chenfangshuo/G474PulseGen/screenshots/verification_2026-09/after_code-hygiene/1-1_sync_jitter.png

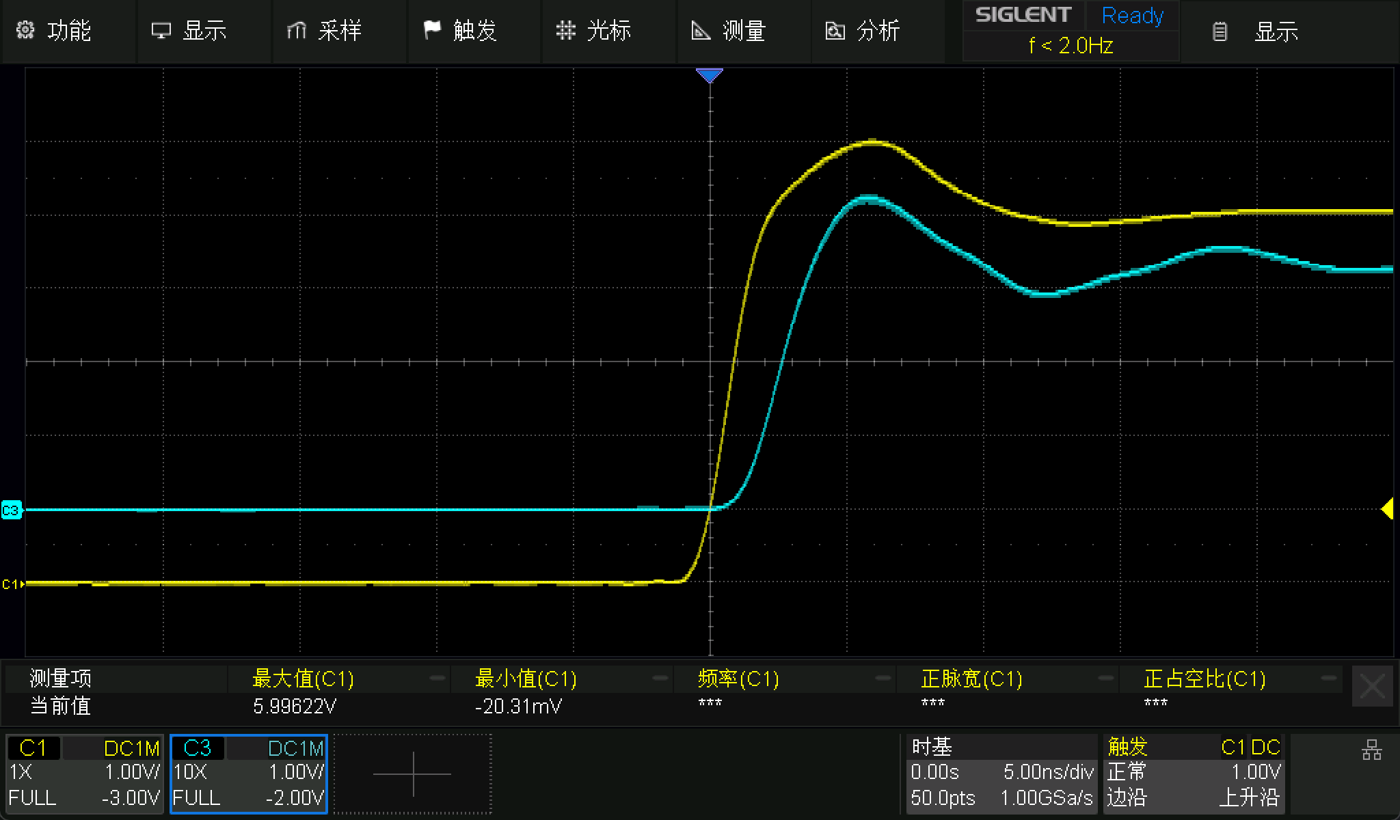
screenshots/verification_2026-09/after_code-hygiene/1-1_sync_jitter.png
