chenfangshuo/G474PulseGen/screenshots/verification_2026-09/after_code-hygiene/1-3_oled_pages/20260911_180122_COMPPWM_013.png

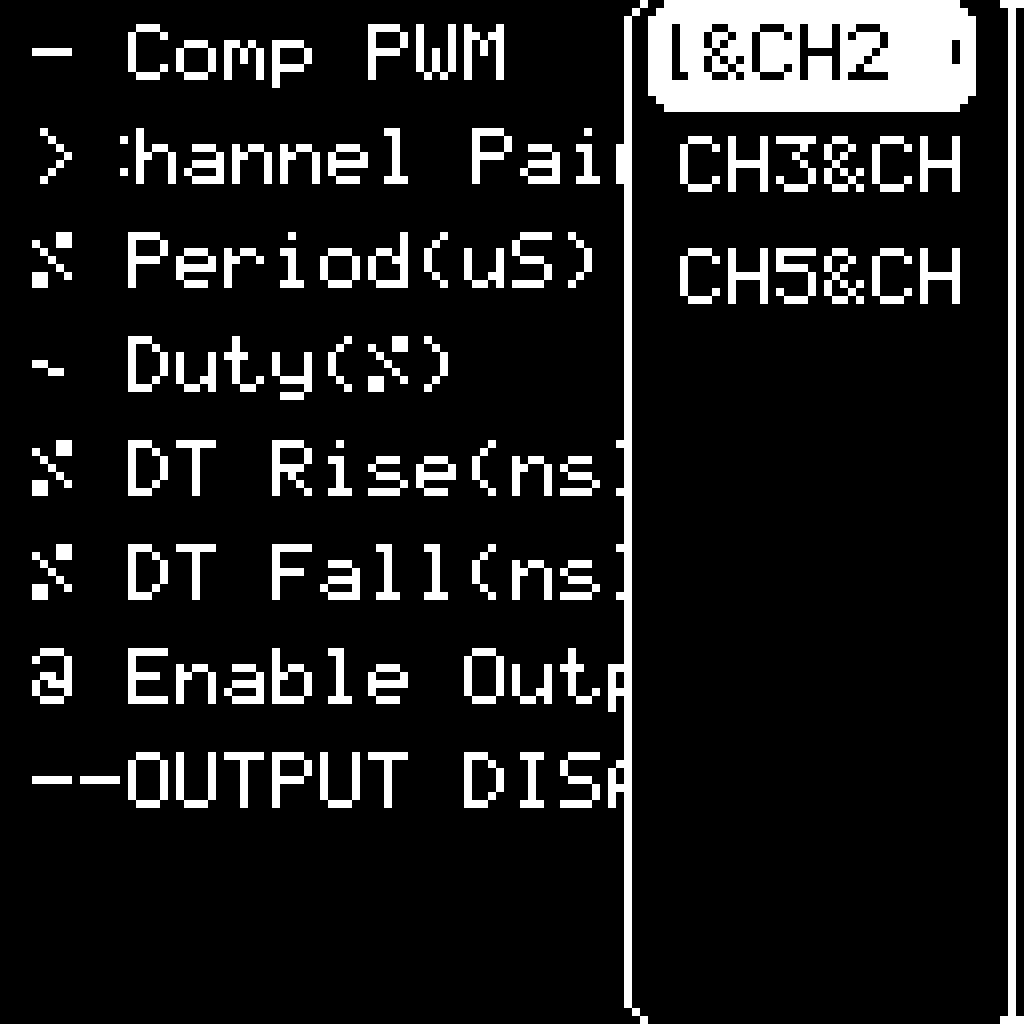
screenshots/verification_2026-09/after_code-hygiene/1-3_oled_pages/20260911_180122_COMPPWM_013.png
