chenfangshuo/G474PulseGen/screenshots/verification_2026-09/baseline_fbbc384/0-4_oled_pages/20260911_170125_NONE_010.png

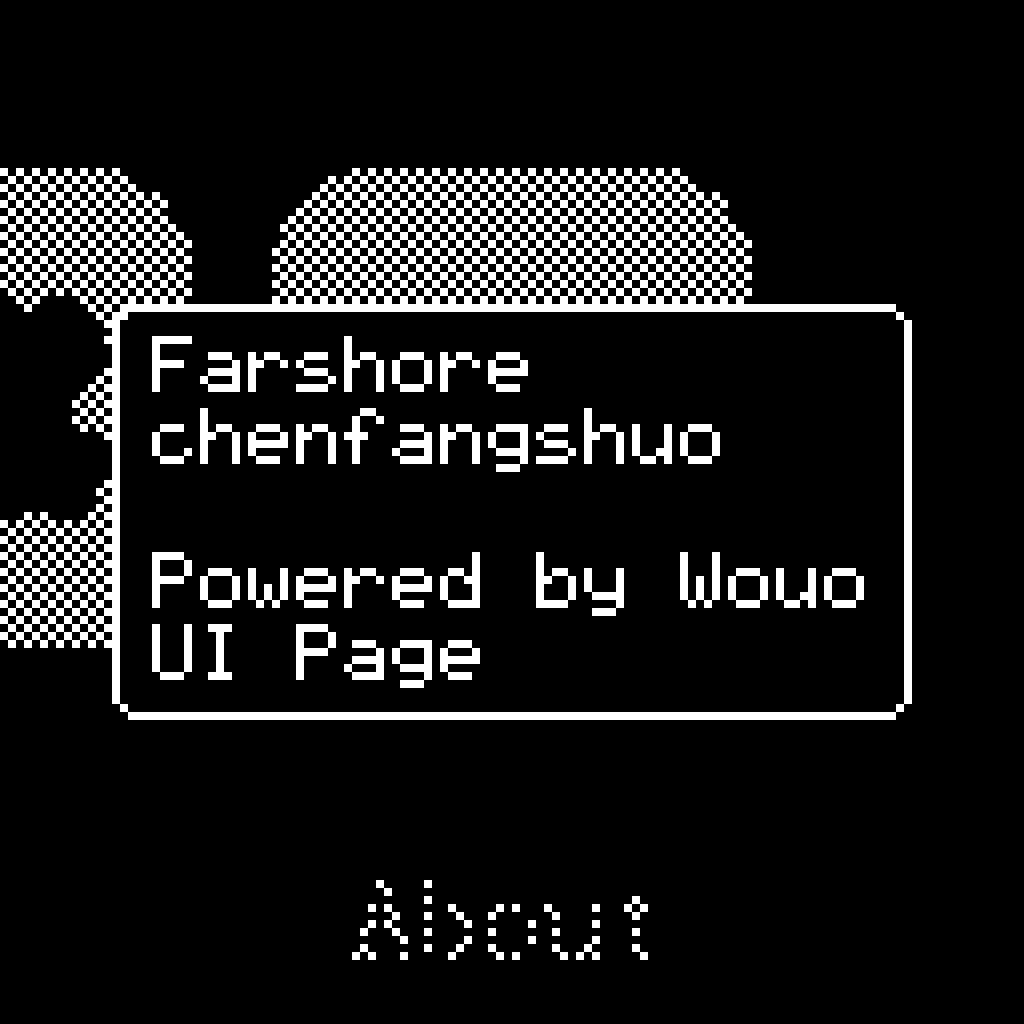
screenshots/verification_2026-09/baseline_fbbc384/0-4_oled_pages/20260911_170125_NONE_010.png
