chenfangshuo/G474PulseGen/screenshots/verification_2026-09/baseline_fbbc384/0-4_oled_pages/20260911_170133_NPULSE_011.png

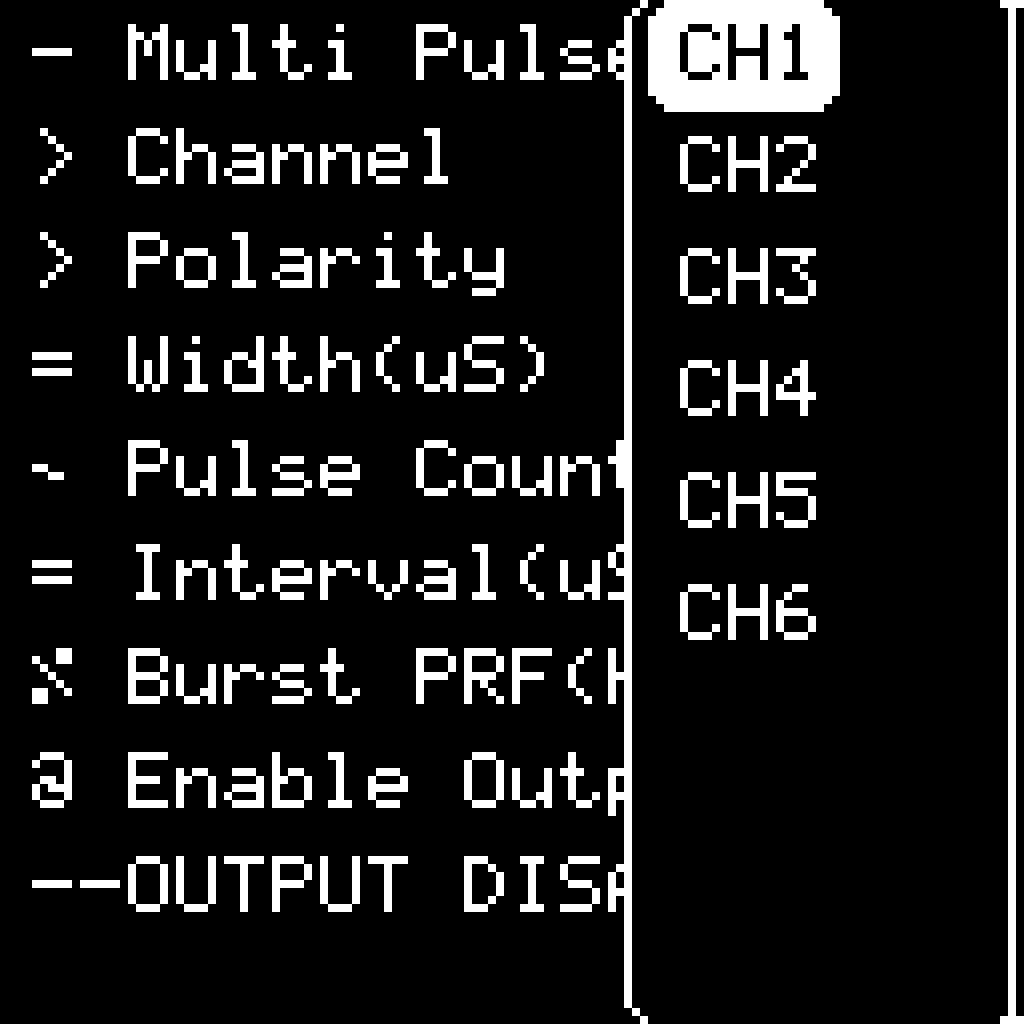
screenshots/verification_2026-09/baseline_fbbc384/0-4_oled_pages/20260911_170133_NPULSE_011.png
