chenfangshuo/G474PulseGen/G474PulseGen.ioc

Mcu.UserName=STM32G474CETx
PA0.Signal=S_TIM2_CH1
PA1.Signal=S_TIM2_CH2
PA10.Signal=HRTIM1_CHB1
PA11.Signal=HRTIM1_CHB2
PA12.Signal=GPIO_Output
PA13.Signal=SYS_JTMS-SWDIO
PA14.Signal=SYS_JTCK-SWCLK
PA4.Signal=GPIO_Input
PA5.Signal=GPIO_Input
PA6.Signal=GPIO_Input
PA7.Signal=GPIO_Input
PA8.Signal=HRTIM1_CHA1
PA9.Signal=HRTIM1_CHA2
PB0.Signal=GPIO_Input
PB1.Signal=GPXTI1
PB10.Signal=USART3_TX
PB11.Signal=USART3_RX
PB14.Signal=HRTIM1_CHD1
PB15.Signal=HRTIM1_CHD2
PB3.Signal=SPI1_SCK
PB4.Signal=GPIO_Output
PB5.Signal=SPI1_MOSI
PB6.Signal=GPIO_Output
PB7.Signal=GPIO_Output
PC13.Signal=GPIO_Input
PC14-OSC32_IN.Signal=GPIO_Input
PC15-OSC32_OUT.Signal=GPIO_Input
PF0-OSC_IN.Signal=RCC_OSC_IN
PF1-OSC_OUT.Signal=RCC_OSC_OUT
