chenfangshuo/G474PulseGen/Core/Inc/main.h

#define LOADSW_GPIO_Port          GPIOA
#define LOADSW_Pin                GPIO_PIN_12
#define PWR1_DT_GPIO_Port         GPIOC
#define PWR1_DT_Pin               GPIO_PIN_14
#define PWR2_DT_GPIO_Port         GPIOC
#define PWR2_DT_Pin               GPIO_PIN_15
