chenfangshuo/G474PulseGen/Core/Src/OLED_Fonts.c

/*
 * 本文件改编自 B 站「江协科技」的开源 STM32 教学库, 在此致谢原作者的无私分享。
 *     官方网站: https://jiangxiekeji.com/
 *     原作品公开发布供下载, 但未声明明确的开源许可, 此处保留署名以尊重原作者。
 *
 * 本项目作者编写与修改的部分, 按 MIT 许可证发布, 详见根目录 LICENSE 文件。
 */
#include "OLED_Fonts.h"

/*宽10像素，高20像素*/
const uint8_t OLED_F10x20[][30] =
{

    {0x00,0x00,0x00,0x00,0x00,0x00,0x00,0x00,0x00,0x00,0x00,0x00,0x00,0x00,0x00,0x00,0x00,0x00,0x00,0x00,0x00,0x00,0x00,0x00,0x00,0x00,0x00,0x00,0x00,0x00},/*" ",0*/
    {0x00,0x00,0x00,0xE0,0xF0,0xF0,0xE0,0x00,0x00,0x00,0x00,0x00,0x00,0x03,0xDF,0xDF,0x03,0x00,0x00,0x00,0x00,0x00,0x00,0x00,0x00,0x00,0x00,0x00,0x00,0x00},/*"!",1*/
    {0x00,0x00,0x70,0x70,0x00,0x00,0x70,0x70,0x00,0x00,0x00,0x00,0x00,0x00,0x00,0x00,0x00,0x00,0x00,0x00,0x00,0x00,0x00,0x00,0x00,0x00,0x00,0x00,0x00,0x00},/*""",2*/
    {0x00,0x80,0xF0,0xF0,0x80,0x80,0xF0,0xF0,0x80,0x00,0x00,0x19,0xFF,0xFF,0x19,0x19,0xFF,0xFF,0x19,0x00,0x00,0x00,0x00,0x00,0x00,0x00,0x00,0x00,0x00,0x00},/*"#",3*/
    {0x00,0xC0,0xE0,0xF0,0x3C,0x3C,0x70,0x60,0x40,0x00,0x00,0x20,0x61,0xE3,0xC3,0xC6,0xFC,0x78,0x30,0x00,0x00,0x00,0x00,0x00,0x03,0x03,0x00,0x00,0x00,0x00},/*"$",4*/
    {0x30,0x78,0x48,0x78,0x30,0xC0,0xF0,0x30,0x00,0x00,0x00,0xC0,0xF0,0x3C,0x0F,0x63,0xF0,0x90,0xF0,0x60,0x00,0x00,0x00,0x00,0x00,0x00,0x00,0x00,0x00,0x00},/*"%",5*/
    {0x00,0x00,0x40,0xE0,0xB0,0x10,0xB0,0xE0,0x40,0x00,0x00,0x38,0x7C,0xC6,0xC3,0xC1,0xE5,0x7C,0xCC,0x84,0x00,0x00,0x00,0x00,0x00,0x00,0x00,0x00,0x00,0x00},/*"&",6*/
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
};/*25x128*/

const uint8_t OLED_UI_LOGOGithub[] = { 
    0x00,0x00,0x00,0x00,0x00,0x00,0x00,0x00,0x00,0x00,0x80,0x80,0xC0,0xC0,0xE0,0xE0,0xE0,0xE0,0xE0,0xE0,0xE0,0xC0,0xC0,0xC0,0x80,0x80,0x00,0x00,0x00,0x00,0x00,0x00,0x00,0xC0,0xC0,0xC0,0xC0,0xC0,0xC0,0xC0,0x00,0x00,0x00,0x00,0x00,0x00,0x00,0x00,0x00,0x80,0x80,0xC0,0x00,0x00,0x00,0x00,0x00,0x00,0x00,0xC0,0xC0,0xC0,0xC0,0xC0,0xC0,0xC0,0x00,0x00,0x00,0x00,0x00,0x00,0x00,0x00,0x00,0x00,0x00,0x00,0x00,0x00,0x00,0x00,0x00,0x00,0x00,0x00,0x00,0x00,0x00,0x00,0x00,0x00,0x00,0x00,0x00,0x00,0x00,0x00,0x00,0x00,0x00,0x00,0x00,0x00,0xC0,0xC0,0xC0,0xC0,0xC0,0xC0,0xC0,0x00,0x00,0x00,0x00,0x00,0x00,0x00,0x00,0x00,0x00,0x00,0x00,0x00,0x00,0x00,0x00,0x00,0x00,0x00,0x00,0x00,0x00,0xC0,0xF0,0xFC,0xFE,0xFF,0xFF,0xFF,0xFF,0x3F,0x1F,0x0F,0x0F,0x07,0x07,0x0F,0x0F,0x1F,0x3F,0x3F,0x1F,0x1F,0x1F,0x1E,0x18,0x00,0x00,0x00,0x00,0xE7,0xE7,0xE7,0xE7,0xE7,0xE7,0xE7,0x00,0x00,0x00,0xE0,0xE0,0xE0,0xFE,0xFF,0xFF,0xFF,0xFF,0xFF,0xE0,0xE0,0xE0,0xE0,0x00,0x00,0x00,0xFF,0xFF,0xFF,0xFF,0xFF,0xFF,0xFF,0xC0,0xE0,0xE0,0xF0,0xF0,0xF0,0xF0,0xF0,0xE0,0xE0,0xC0,0x00,0x00,0x00,0x00,0x00,0xE0,0xE0,0xE0,0xE0,0xE0,0xE0,0x00,0x00,0x00,0x00,0x00,0xE0,0xE0,0xE0,0xE0,0xE0,0xE0,0xE0,0x00,0x00,0x00,0x00,0xFF,0xFF,0xFF,0xFF,0xFF,0xFF,0xFF,0xE0,0xE0,0xE0,0xF0,0xF0,0xF0,0xF0,0xE0,0xE0,0xC0,0x80,0x00,0x00,0x00,0x00,0x00,0x00,0x00,0x00,0x00,0x00,0x00,0x1F,0xFF,0xFF,0xFF,0xFF,0xFF,0xFF,0xFF,0xC0,0x80,0x00,0x00,0x00,0x3F,0x3F,0x3F,0x3F,0xBF,0xFF,0xFF,0xFF,0xFF,0xFF,0xFF,0xFF,0x00,0x00,0x00,0xFF,0xFF,0xFF,0xFF,0xFF,0xFF,0xFF,0x00,0x00,0x00,0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
};/*32x64*/


/*按照上面的格式，在这个位置加入新的图像数据*/
//...

/*********************图像数据*/


/*****************江协科技|版权所有****************/
/*****************jiangxiekeji.com*****************/
