chenfangshuo/G474PulseGen/Core/Src/hrtim.c

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
/* Includes ------------------------------------------------------------------*/
#include "hrtim.h"

HRTIM_HandleTypeDef hhrtim1;

/* HRTIM1 init function */
void MX_HRTIM1_Init(void)
{

  HRTIM_TimeBaseCfgTypeDef pTimeBaseCfg = {0};
  HRTIM_TimerCtlTypeDef pTimerCtl = {0};
  HRTIM_TimerCfgTypeDef pTimerCfg = {0};
  HRTIM_CompareCfgTypeDef pCompareCfg = {0};
  HRTIM_OutputCfgTypeDef pOutputCfg = {0};

  hhrtim1.Instance = HRTIM1;
  hhrtim1.Init.HRTIMInterruptResquests = HRTIM_IT_NONE;
  hhrtim1.Init.SyncOptions = HRTIM_SYNCOPTION_NONE;
  if (HAL_HRTIM_Init(&hhrtim1) != HAL_OK)
  {
    Error_Handler();
  }
  if (HAL_HRTIM_DLLCalibrationStart(&hhrtim1, HRTIM_CALIBRATIONRATE_3) != HAL_OK)
  {
    Error_Handler();
  }
  if (HAL_HRTIM_PollForDLLCalibration(&hhrtim1, 10) != HAL_OK)
  {
    Error_Handler();
  }
  pTimeBaseCfg.Period = 65503;
  pTimeBaseCfg.RepetitionCounter = 0;
  pTimeBaseCfg.PrescalerRatio = HRTIM_PRESCALERRATIO_MUL32;
  pTimeBaseCfg.Mode = HRTIM_MODE_SINGLESHOT;
  if (HAL_HRTIM_TimeBaseConfig(&hhrtim1, HRTIM_TIMERINDEX_TIMER_B, &pTimeBaseCfg) != HAL_OK)
  {
    Error_Handler();
  }
  pTimerCtl.UpDownMode = HRTIM_TIMERUPDOWNMODE_UP;
  pTimerCtl.TrigHalf = HRTIM_TIMERTRIGHALF_DISABLED;
  pTimerCtl.GreaterCMP3 = HRTIM_TIMERGTCMP3_EQUAL;
  pTimerCtl.GreaterCMP1 = HRTIM_TIMERGTCMP1_EQUAL;
  pTimerCtl.DualChannelDacEnable = HRTIM_TIMER_DCDE_DISABLED;
  if (HAL_HRTIM_WaveformTimerControl(&hhrtim1, HRTIM_TIMERINDEX_TIMER_B, &pTimerCtl) != HAL_OK)
  {
    Error_Handler();
  }
  pTimerCfg.InterruptRequests = HRTIM_TIM_IT_NONE;
  pTimerCfg.DMARequests = HRTIM_TIM_DMA_NONE;
  pTimerCfg.DMASrcAddress = 0x0000;
  pTimerCfg.DMADstAddress = 0x0000;
  pTimerCfg.DMASize = 0x1;
  pTimerCfg.HalfModeEnable = HRTIM_HALFMODE_DISABLED;
  pTimerCfg.InterleavedMode = HRTIM_INTERLEAVED_MODE_DISABLED;
  pTimerCfg.StartOnSync = HRTIM_SYNCSTART_DISABLED;
  pTimerCfg.ResetOnSync = HRTIM_SYNCRESET_DISABLED;
  pTimerCfg.DACSynchro = HRTIM_DACSYNC_NONE;
  pTimerCfg.PreloadEnable = HRTIM_PRELOAD_DISABLED;
  pTimerCfg.UpdateGating = HRTIM_UPDATEGATING_INDEPENDENT;
  pTimerCfg.BurstMode = HRTIM_TIMERBURSTMODE_MAINTAINCLOCK;
  pTimerCfg.RepetitionUpdate = HRTIM_UPDATEONREPETITION_DISABLED;
  pTimerCfg.PushPull = HRTIM_TIMPUSHPULLMODE_DISABLED;
  pTimerCfg.FaultEnable = HRTIM_TIMFAULTENABLE_NONE;
  pTimerCfg.FaultLock = HRTIM_TIMFAULTLOCK_READWRITE;
  pTimerCfg.DeadTimeInsertion = HRTIM_TIMDEADTIMEINSERTION_DISABLED;
  pTimerCfg.DelayedProtectionMode = HRTIM_TIMER_A_B_C_DELAYEDPROTECTION_DISABLED;
  pTimerCfg.UpdateTrigger = HRTIM_TIMUPDATETRIGGER_NONE;
  pTimerCfg.ResetTrigger = HRTIM_TIMRESETTRIGGER_NONE;
  pTimerCfg.ResetUpdate = HRTIM_TIMUPDATEONRESET_DISABLED;
  pTimerCfg.ReSyncUpdate = HRTIM_TIMERESYNC_UPDATE_UNCONDITIONAL;
  if (HAL_HRTIM_WaveformTimerConfig(&hhrtim1, HRTIM_TIMERINDEX_TIMER_B, &pTimerCfg) != HAL_OK)
  {
    Error_Handler();
  }
  pCompareCfg.CompareValue = 0;
  if (HAL_HRTIM_WaveformCompareConfig(&hhrtim1, HRTIM_TIMERINDEX_TIMER_B, HRTIM_COMPAREUNIT_1, &pCompareCfg) != HAL_OK)
  {
    Error_Handler();
  }
  pCompareCfg.CompareValue = 5435;
  pCompareCfg.AutoDelayedMode = HRTIM_AUTODELAYEDMODE_REGULAR;
  pCompareCfg.AutoDelayedTimeout = 0x0000;

  if (HAL_HRTIM_WaveformCompareConfig(&hhrtim1, HRTIM_TIMERINDEX_TIMER_B, HRTIM_COMPAREUNIT_2, &pCompareCfg) != HAL_OK)
  {
    Error_Handler();
  }
  pCompareCfg.CompareValue = 6000;
  if (HAL_HRTIM_WaveformCompareConfig(&hhrtim1, HRTIM_TIMERINDEX_TIMER_B, HRTIM_COMPAREUNIT_3, &pCompareCfg) != HAL_OK)
  {
    Error_Handler();
  }
  pCompareCfg.CompareValue = 8000;

  if (HAL_HRTIM_WaveformCompareConfig(&hhrtim1, HRTIM_TIMERINDEX_TIMER_B, HRTIM_COMPAREUNIT_4, &pCompareCfg) != HAL_OK)
  {
    Error_Handler();
  }
  pOutputCfg.Polarity = HRTIM_OUTPUTPOLARITY_HIGH;
  pOutputCfg.SetSource = HRTIM_OUTPUTSET_TIMCMP1|HRTIM_OUTPUTSET_TIMCMP3;
  pOutputCfg.ResetSource = HRTIM_OUTPUTRESET_TIMCMP2|HRTIM_OUTPUTRESET_TIMCMP4;
  pOutputCfg.IdleMode = HRTIM_OUTPUTIDLEMODE_NONE;
  pOutputCfg.IdleLevel = HRTIM_OUTPUTIDLELEVEL_INACTIVE;
  pOutputCfg.FaultLevel = HRTIM_OUTPUTFAULTLEVEL_NONE;
  pOutputCfg.ChopperModeEnable = HRTIM_OUTPUTCHOPPERMODE_DISABLED;
  pOutputCfg.BurstModeEntryDelayed = HRTIM_OUTPUTBURSTMODEENTRY_REGULAR;
  if (HAL_HRTIM_WaveformOutputConfig(&hhrtim1, HRTIM_TIMERINDEX_TIMER_B, HRTIM_OUTPUT_TB2, &pOutputCfg) != HAL_OK)
  {
    Error_Handler();
  }
  HAL_HRTIM_MspPostInit(&hhrtim1);

}

void HAL_HRTIM_MspInit(HRTIM_HandleTypeDef* hrtimHandle)
{

  if(hrtimHandle->Instance==HRTIM1)
  {
    /* HRTIM1 clock enable */
    __HAL_RCC_HRTIM1_CLK_ENABLE();

    /* HRTIM1 interrupt Init */
    HAL_NVIC_SetPriority(HRTIM1_Master_IRQn, 0, 0);
    HAL_NVIC_EnableIRQ(HRTIM1_Master_IRQn);
    HAL_NVIC_SetPriority(HRTIM1_TIMB_IRQn, 0, 0);
    HAL_NVIC_EnableIRQ(HRTIM1_TIMB_IRQn);
  }
}

void HAL_HRTIM_MspPostInit(HRTIM_HandleTypeDef* hrtimHandle)
{

  GPIO_InitTypeDef GPIO_InitStruct = {0};
  if(hrtimHandle->Instance==HRTIM1)
  {
    __HAL_RCC_GPIOB_CLK_ENABLE();
    __HAL_RCC_GPIOA_CLK_ENABLE();
    /**HRTIM1 GPIO Configuration
    PB14     ------> HRTIM1_CHD1
    PB15     ------> HRTIM1_CHD2
    PA8     ------> HRTIM1_CHA1
    PA9     ------> HRTIM1_CHA2
    PA10     ------> HRTIM1_CHB1
    PA11     ------> HRTIM1_CHB2
    */
    GPIO_InitStruct.Pin = GPIO_PIN_14|GPIO_PIN_15;
    GPIO_InitStruct.Mode = GPIO_MODE_AF_PP;
    GPIO_InitStruct.Pull = GPIO_NOPULL;
    GPIO_InitStruct.Speed = GPIO_SPEED_FREQ_VERY_HIGH;
    GPIO_InitStruct.Alternate = GPIO_AF13_HRTIM1;
    HAL_GPIO_Init(GPIOB, &GPIO_InitStruct);

    GPIO_InitStruct.Pin = GPIO_PIN_8|GPIO_PIN_9|GPIO_PIN_10|GPIO_PIN_11;
    GPIO_InitStruct.Mode = GPIO_MODE_AF_PP;
    GPIO_InitStruct.Pull = GPIO_NOPULL;
    GPIO_InitStruct.Speed = GPIO_SPEED_FREQ_VERY_HIGH;
    GPIO_InitStruct.Alternate = GPIO_AF13_HRTIM1;
    HAL_GPIO_Init(GPIOA, &GPIO_InitStruct);

  /* USER CODE BEGIN HRTIM1_MspPostInit 1 */
    /** HRTIM1 Timer C GPIO Configuration (严格遵循 HARDWARE.md §5.1)
    PB13     ------> HRTIM1_CHC2 (Y7 = SYNC OUT, HRTIM 硬件输出)
    PB12     ------> GPIO 推挽输出 (Y8 = 帧/猝发标记, 软件控制)
    */
    GPIO_InitStruct.Pin = GPIO_PIN_13;
    GPIO_InitStruct.Mode = GPIO_MODE_AF_PP;
    GPIO_InitStruct.Pull = GPIO_NOPULL;
    GPIO_InitStruct.Speed = GPIO_SPEED_FREQ_VERY_HIGH;
    GPIO_InitStruct.Alternate = GPIO_AF13_HRTIM1;
    HAL_GPIO_Init(GPIOB, &GPIO_InitStruct);

    GPIO_InitStruct.Pin = GPIO_PIN_12;
    GPIO_InitStruct.Mode = GPIO_MODE_OUTPUT_PP;
    GPIO_InitStruct.Pull = GPIO_NOPULL;
    GPIO_InitStruct.Speed = GPIO_SPEED_FREQ_VERY_HIGH;
    HAL_GPIO_Init(GPIOB, &GPIO_InitStruct);
    HAL_GPIO_WritePin(GPIOB, GPIO_PIN_12, GPIO_PIN_RESET);   /* 帧标记初始低 */
  /* USER CODE END HRTIM1_MspPostInit 1 */
  }

}

void HAL_HRTIM_MspDeInit(HRTIM_HandleTypeDef* hrtimHandle)
{

  if(hrtimHandle->Instance==HRTIM1)
  {
    /* Peripheral clock disable */
    __HAL_RCC_HRTIM1_CLK_DISABLE();

    /* HRTIM1 interrupt Deinit */
    HAL_NVIC_DisableIRQ(HRTIM1_Master_IRQn);
    HAL_NVIC_DisableIRQ(HRTIM1_TIMB_IRQn);
  }
}
