chenfangshuo/G474PulseGen/Core/Inc/usart.h

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
/* Define to prevent recursive inclusion -------------------------------------*/
#ifndef __USART_H__
#define __USART_H__

#ifdef __cplusplus
extern "C" {
#endif

/* Includes ------------------------------------------------------------------*/
#include "main.h"

extern UART_HandleTypeDef huart3;

/* USER CODE BEGIN Private defines */
/* USART3_TX -> DMA1_Channel2 的句柄。CubeMX 也会在 stm32g4xx_it.c 的
 * "External variables" 区声明一份 (供 DMA1_Channel2_IRQHandler 使用),
 * 两处重复声明是合法的; 这里保留是为了让本模块的句柄就近可见。 */
extern DMA_HandleTypeDef hdma_usart3_tx;
/* USER CODE END Private defines */

void MX_USART3_UART_Init(void);

/* USER CODE BEGIN Prototypes */
/* 发送完成接口 UartComm_TxComplete() 的声明在 uart_comm.h ——
 * 本模块 (usart.c/uart_comm.c) 都包含该头文件, 此处不再重复声明。 */
/* USER CODE END Prototypes */

#ifdef __cplusplus
}
#endif

#endif /* __USART_H__ */
