chenfangshuo/G474PulseGen/Core/Src/WouoUI_user.c

#include "WouoUI_user.h"
#include "WouoUI.h"
#include "math.h"
#include "string.h"
#include "stm32g4xx.h"
#include "hrtim.h"
#include "Pulse.h"
#include "Preset.h"
/* 注: 原此处有 g_pulse_out_enabled / g_pulse_mode / g_12v_enable 三条手写 extern。
 * 前两条与 Pulse.h 中的声明重复 (本文件已 include Pulse.h), 第三条已在 main.h
 * 中正式声明 (经 Pulse.h 传递包含), 均已删除。 */

//--------定义页面对象
// 全部页面对象仅本文件使用 (已核验无跨文件引用), 故加 static 收敛符号可见性。
// 注意: 下方的 Option[]/String[] 数据数组被 Preset.c / uart_comm.c / main.c 引用,
// 属对外契约, 不可加 static。
static TitlePage main_page;
    static ListPage n_pulse_page;
    static ListPage n_pulse_long_page;
    static ListPage double_pulse_page;
    static ListPage pwm_page;
    static ListPage pwm_long_page;
    static ListPage comp_pwm_page;
    static ListPage comp_pwm_long_page;
        static ListWin ch_sel_page;
        static ListWin polarity_sel_page;
        static ListWin comp_pair_sel_page;
        static SpinWin pw_spin_page;
    static ListPage setting_page;
        static MsgWin common_msg_page; //共用的消息弹窗
        static ValWin common_val_page; //共用的数值弹窗
    static ListPage about_page;
        static ListPage about_origin_page;
            static ListPage about_wououi_page;
            static ListPage about_version_page;
//--------定义每个页面需要的一些参数
// 部分页面内选项个数
#define MAIN_PAGE_NUM         9 //因为有两个数组所以做宏定义
// 定义部分页面选项
//********main页面的选项
static Option main_option_array[MAIN_PAGE_NUM] =
{
        // {.text = (char *)"! WouoUI"},
        {.text = (char *)"+ Multi Pulse"},
        {.text = (char *)"+ Multi Pulse Long"},
        {.text = (char *)"+ Double Pulse"},
        {.text = (char *)"+ PWM"},
        {.text = (char *)"+ PWM Long"},
        {.text = (char *)"+ Comp PWM"},
        {.text = (char *)"+ Comp PWM Long"},
        {.text = (char *)"+ Setting"},
        // {.text = (char *)"~ This is a volumn page for test win in win",},
        // {.text = (char *)"% Spin", .val = 123456, .decimalNum = DecimalNum_2},
        {.text = (char *)"! About"}
};
// main页面的图标
static Icon main_icon_array[MAIN_PAGE_NUM] =
    {
        // [0] = {0xFC, 0xFE, 0xFF, 0x3F, 0x1F, 0x0F, 0x07, 0x03, 0x03, 0x01, 0x01, 0x01, 0x01, 0x01, 0x01, 0x01,
        //        0x01, 0x01, 0x01, 0x01, 0x01, 0x03, 0x07, 0x07, 0x0F, 0x1F, 0x3F, 0xFF, 0xFE, 0xFC, 0xFF, 0x01,
        //        0x00, 0x00, 0x00, 0x00, 0xFC, 0xFC, 0xFC, 0xFC, 0x00, 0x00, 0x00, 0x00, 0x00, 0xFC, 0xFC, 0xFC,
        //        0x00, 0x00, 0xFC, 0xFC, 0xFC, 0xFC, 0x00, 0x00, 0x00, 0x00, 0x03, 0xFF, 0xFF, 0xF0, 0xC0, 0x00,
        //        0x00, 0x00, 0x03, 0x07, 0x0F, 0x1F, 0x3E, 0x3C, 0x3C, 0x3C, 0x1E, 0x1F, 0x0F, 0x03, 0x00, 0x00,
        //        0x1F, 0x3F, 0x3F, 0x1F, 0x00, 0x00, 0x00, 0xC0, 0xF0, 0xFF, 0xCF, 0xDF, 0xFF, 0xFF, 0xFE, 0xFC,
        //        0xF8, 0xF8, 0xF0, 0xF0, 0xE0, 0xE0, 0xE0, 0xE0, 0xE0, 0xE0, 0xE0, 0xE0, 0xE0, 0xE0, 0xF0, 0xF0,
        //        0xF8, 0xF8, 0xFC, 0xFE, 0xFF, 0xFF, 0xDF, 0xCF}, // logo
        [0] = {
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
