chenfangshuo/G474PulseGen/(commit log)

2026-08-28 refactor: 完成Step 1&2(硬件宏封装/Pulse结构体重构/补齐Timer C)
2026-08-28 feat: complete step 3-5 (deadtime, 180deg interleaved pwm, softstart state machine, emergency stop)
2026-08-28 feat: complete OLED async DMA, WouoUI float render and pulse deadtime/interleave/softstart refactor
2026-08-28 bugfix: 修正长PWM切换通道，周期变为1ms
2026-08-28 perf(key): 优化按键扫描频率并降低TIM7中断开销
2026-08-29 bugfix: NVIC 中断优先级配置，Long PWM 字符串匹配
    [WouoUI_user.c, main.c]
2026-08-29 bugfix: 修正 HAL_GPIO_EXTI_Callback 中的 CR2 触发赋值，修正长周期 PWM（TIM5）波形反相问题
    [Pulse.c, main.c]
2026-08-30 fix(core): resolve interrupt priority inversion, isr deadlocks, and concurrent state race conditions
    [Key.c, OLED_driver.c, Pulse.c, Pulse.h, WouoUI_anim.c, WouoUI_user.c]
2026-08-30 fix(ui): remove redundant inline break statements in animation settings callback
    [WouoUI_user.c]
2026-08-30 fix(pulse): harden emergency stop against null pointers and enable hrtim pwm reset-update
    [Pulse.c, main.c]
2026-08-30 fix(pulse): eliminate pwm period reduction distortion and lock unvalidated features
    [Pulse.c, WouoUI_user.c]
2026-08-30 fix(pulse): correct pulse width scaling, disable preload for single-shot, and automate load switch
    [Pulse.c, WouoUI_user.c, main.c]
2026-08-30 clenup:1. 180° 交错并联 PWM（Interleaved PWM）；2. 软启动状态机（Soft Start）；3. 死区时间发生器（Dead Time Generator）
2026-08-30 feature：增加多脉冲功能
2026-08-30 feature(pulse): 新增 HRTIM/TIM5 互补 PWM 发波模式
    - 主菜单新增 Comp PWM / Comp PWM Long 两个入口 (复用 PWM/PWM Long 图标)
    - HRTIM 互补: DeadTimeInsertion + 死区硬件生成互补 (Tx1 主路 CMP1/CMP2, Tx2 自动互补), 上升/下降沿死区独立可调 (0~1000ns)
    - TIM5 超长互补: 32 位时基 + CC1/CC2/CC3 三比较事件软件死区 (先关后开, BSRR 原子写)
    - 通道对选择对齐 HARDWARE.md: CH1&CH2->Timer B, CH3&CH4->Timer A, CH5&CH6->Timer D, CH7&CH8->Timer C
    - EmergencyStop/Disable_Output 双输出瞬间同时拉低, 严禁直通
    - 参数更新采用局部结构体配置与分频重对齐判据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
2026-08-30 feat(pulse): Y7/Y8 改专用 SYNC OUT 与帧标记, 新增 Burst PRF 猝发重复
    Step 0: 剥离 Y7/Y8 发波, 通道缩为 CH1~CH6, 互补对缩为 Timer A/B/D
    Step 1: Y7(PB13)=Timer C CH2 单次 200ns 同步脉冲, EXTI 单写操作与首脉冲 ns 对齐
    Step 2: Y8(PB12)=帧/猝发标记(软件 GPIO), TIM3 作 PRF 时基支持 1~100kHz 周期猝发
2026-08-30 fix(pulse): Burst 模式状态提示与 PRF 按位快调
    - Burst 模式(PRF>0)使能后状态提示改为 --BURST RUNNING--
    - Burst PRF 由 ValWin(步进1)改为 SpinWin 按位调节, 一次可 ±1000
    - 进入 Multi Pulse 页时复位残留 PRF 状态
    [WouoUI_user.c, main.c]
2026-08-30 feat(pulse): 互补死区扩展至 12us + Preset 参数存储/调出
    Step 3: 死区分频档新增 DIV2/DIV4, 上限 1000ns -> 12000ns; DT Rise/Fall 改 SpinWin 按位快调
    Step 4: 新增 Preset 模块(HAL_FLASH 写最后一页, CRC 校验), Setting 页 Save/Load Preset;
    进入模式改用 Preset_ApplyMode 从数组施加参数, 调出后即生效
2026-08-30 feat(pulse): 12V_OUT 手动控制 + HRTIM 硬件 Fault 输入
    Step 5: 12V_OUT 改手动开关(Setting 页 @ 12V Output), 掉电仍瞬间切断
    Step 6: PA15=HRTIM_FLT2(AF13) 硬件故障封锁, Timer A/B/D FaultEnable=FLT2,
    输出 FaultLevel=INACTIVE, FLT2 中断回调软件安全网关断
2026-08-30 fix(ui): 12V 默认使能 + 精简设置页 + Fault 后自动关输出并弹窗
    - 12V_OUT 默认使能 (g_12v_enable=true, 复选框初值 1)
    - 设置页仅保留 12V Output / Save Preset / Load Preset, 12V 置顶
    - Fault 后: ISR 置 g_fault_flag, main 循环关闭当前模式 Enable 按钮并弹窗 Fault
    [Pulse.c, Pulse.h, WouoUI_user.c, WouoUI_user.h, main.c]
2026-08-31 feat(comm): PC 端 OLED 镜像同步 + SCPI 远程控制 + 虚拟按键 + 编码器 + exe 打包
    - 新增 USART3 (460800 8N1, DMA TX) 通信协议层 uart_comm: 二进制帧协议
    (同步头+类型+长度+CRC16), OLED 镜像 RLE 压缩推流, SCPI 文本控制,
    虚拟按键注入, Ping-Pong 双缓冲 + 忙则丢帧, 连接状态机 + RXNE 风暴保护
    - OLED 脏帧回调触发镜像推流, 连接建立主动推首帧消除纯色等待
    - SCPI 支持 OUTP/MODE/CHAN/POL/PULS/PWM/COMP/LPWM/BURST/TRIG/12V/PRESET/STAT/KEY
    - OUTP:ON/OFF 与 12V:ON/OFF 双向同步 UI Enable Output / 12V Output 复选框
    - 上位机 oled_mirror.py: 1:1 镜像显示 + 虚拟方向键 + SCPI 命令行 + 心跳,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
2026-08-31 feat(comm): SCPI 远程控制完善 + 上位机交互增强
    - SCPI: MODE/CHAN/POL 复用物理路径同步屏幕, 新增 DPULS 双脉冲/HELP/*IDN?
    - 固件: 状态变化主动推送(替代轮询), 首帧竞态修复+兜底推帧, FR 计数含 RLE
    - 上位机: 命令历史+TAB补全, 屏幕快照PNG, 后台 TCP SCPI 服务端(127.0.0.1:5025)
    - 上位机: 滚轮按页面类型智能分发, 欢迎画面, 高DPI缩放, RSP折行, 帮助面板
    - 构建: build.bat 英文化, .gitignore 增 screenshots/
    [WouoUI_user.c, WouoUI_user.h, main.c, main.h, oled_mirror.py, uart_comm.c]
2026-08-31 feat(ui): 诊断行显示实时镜像推流帧率与累计帧数
    CRC 诊断行末尾新增 fps(1s 滑动窗口帧率) 与 frames(累计帧数),
    直观观察 MCU 实际推流速率, 不受窗口 30fps 重绘限制。
2026-09-02 feat(ui): 数值弹窗触界回弹 + 列表光标果冻形变
    SpinWin(上下)/ValWin(左右) 数值调到上下限时窗口整体偏移回弹
    ListPage/ListWin 光标触边果冻形变(高度压缩+右侧膨胀+弹回)
    About 弹窗署名更新
2026-09-02 build(cmake): 编译/链接改为极致性能优化
    - 新增 PERF_FLAGS = -O3 -flto -funroll-loops -ffp-contract=fast
    - Debug/Release 均去掉 -O0/-Os，仅保留调试符号差异
    - 链接阶段追加 -flto 启用链接时优化
    - FPU 保持单精度硬件浮点最佳档 (fpv4-sp-d16 + hard ABI)
2026-09-02 fix(flash): 使能 ART 预取缓冲并修正链接脚本 RAM 长度为真实 96K
    - HAL_MspInit 显式使能 PRFTEN 预取，170MHz@4WS 下隐藏顺序取指等待
    - STM32G474XX_FLASH.ld RAM LENGTH 128K→96K，_estack 回落至 0x20018000 真实物理 SRAM 顶部
2026-09-02 docs: 修正 CLAUDE.md 构建指令为 build/Debug
    cmake-build-debug 目录已不存在，实际活跃构建目录为 build/Debug
2026-09-02 docs: 同步 README/HARDWARE 至最新代码并补充 WouoUI-PageVersion 链接
    - SRAM 修正为链接脚本映射的 96KB（另有 32KB CCM）
    - SCPI 命令表补齐 *IDN?/DPULS/HELP + 状态主动推送说明
    - 上位机新增 TCP SCPI 服务端/PNG 快照/命令历史+TAB 等说明
    - 补充 ART 预取与 CMake 极致优化说明
2026-09-04 feat(comm): 波特率升级 2Mbps + 推流延迟/帧率优化
    - 波特率 460800→2Mbps: USART3_BAUDRATE 宏, 上位机默认 2M
    - 推流节流 16→8ms 匹配 TIM6 90Hz 动画步进 (消除 45fps 错拍)
    - 上位机显示 30→60fps; 读线程改 in_waiting 读尽 (消除 ~0.5s 帧延迟)
    - WouoUI 动画结束强制推帧兜底 + 页面渐隐加快 (FADE_ANI 30→15)
2026-09-04 fix(anim): 动画末尾动量耗尽吸附, 消除爬行且保留减速缓冲
    Bresenham 步进末尾剩余 1px 时 pos_err/n 恒为 0 导致停滞 n 帧再跳 1px。
    改为步进后判 step==0 且剩余<=1px 才终点吸附: 保留 step 随 diff 递减的
    自然减速, 仅在步进量真正衰减为 0 时吸附, 不再爬行抽搐也不生硬撞墙。
    [WouoUI_anim.c]
2026-09-04 fix(wheel): SpinWin 滚轮方向与直觉相反
    SpinWin 与 ValWin 对 msg_right/msg_left 语义相反 (前者=减小/右移),
    之前复用同一映射导致 SpinWin 上滚=右移。拆分为各自方向消息:
    SpinWin 上滚=msg_up(增大/左移), ValWin 保持 msg_right(增大)。
    [uart_comm.c]
2026-09-06 feat(comm): SCPI 演示脚本与详细命令参考 + TCP 服务端响应关联修复
    [demo_scripts.py, oled_mirror.py]
2026-09-06 fix(comm): 修复 2Mbps ORE 丢字节致命令偶发超时 + BURST 解析
    [main.c, uart_comm.c]
2026-09-06 fix(ui): SpinWin 调值方向符号对调, 滚轮上=增大/下=减小
    [WouoUI_win.c]
2026-09-06 fix(ui): SpinWin 滚轮/编码器调值方向分离, 各自独立定方向
    [WouoUI_win.c, uart_comm.c]
2026-09-06 fix(pulse)：多脉冲间隔修复
2026-09-10 fix(pulse)：多脉冲间隔修复，修改注释
2026-09-10 docs: 全量重写 README 并同步 HARDWARE 波特率, 图片调色板压缩
    - README.md 按代码实测参数重写: HRTIM 八档分频、七种模式参数表、
    菜单操作、防炸机安全逻辑、SCPI 命令集、踩坑记录
    - 插入 19 张屏幕实拍/示波器实测图 + UI_Anime.webp 动图演示
    - screenshots/ 取消 gitignore; 10 张波形图经 ffmpeg 调色板压缩,
    单张 7.4MB -> ~20KB, 总目录 71MB -> 404KB
    - HARDWARE.md: USART3 波特率 460800 -> 2Mbps (4 处),
    修正中断优先级 (3,3) -> (2,0)
2026-09-10 docs: 移除 README 已知限制中过时的图片体积描述
    波形图经 ffmpeg 调色板压缩后单张约 20KB, 整目录 404KB,
    "单张约 7 MB" 已不再成立, 该条限制删除。
2026-09-10 docs: 补充 MIT+MPL-2.0 混合许可, 补全第三方署名
    - 新增 LICENSE: MIT 全文 + 适用范围说明, 第三方组件各自适用原许可
    - 16 个 WouoUI 框架文件补回 MPL-2.0 声明头 (修复 MPL-2.0 §3.4 合规缺口)
    - WouoUI_user.c/.h 划归自有代码, 适用 MIT
    - Key.c/.h 与 OLED 驱动库共 8 个文件补江协科技致谢头, 按 MIT 发布
    - README 新增「14. 许可证」章节与文末「致谢」章节(含 jiangxiekeji.com)
    [Key.c, Key.h, OLED.c, OLED.h, OLED_Fonts.c, OLED_Fonts.h, OLED_driver.c, OLED_driver.h]
2026-09-10 chore: 工程名 G474-Test → G474PulseGen
    G474-Test 是立项时的临时占位名, 现统一改为 G474PulseGen。
    【改动】
    - CMakeLists.txt: CMAKE_PROJECT_NAME → G474PulseGen
    产物随之变为 build/Debug/G474PulseGen.elf 与 .map
    (add_executable 与 cmake/stm32cubemx 全程用 ${CMAKE_PROJECT_NAME}, 自动派生)
    - G474-Test.ioc → G474PulseGen.ioc (git mv 保留历史)
    同步 ProjectManager.ProjectFileName / ProjectName
    - Core/Src/uart_comm.c: *IDN? 返回串型号段 → G474PulseGen
    第一段厂商 "PulseGen" 保持不变, 避免破坏按厂商字段判断的外部脚本
    (已核对: oled_mirror.py 无 IDN 解析逻辑; demo_scripts.py 调用处 expect=None 不校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
2026-09-11 docs: 补齐 Core 硬件保护与时序的 P0 Doxygen 注释
    批次 1/15。纯注释改动，零代码副作用。
    补充 9 处关键保护/时序函数的 Doxygen 注释，侧重硬件缘由与避坑说明：
    - Pulse_EmergencyStop：五步关断顺序及各步理由；说明为何必须校验 RCC
    时钟与 NULL 句柄（防 HardFault 递归锁死）；记录 ODISR=0xFFFFFFFF 会
    连带关断 TC2/Y7 且上电后不再恢复的既有设计缺口
    - Pulse_Fault_Init：PA15 低有效电气来源、Filter=2 的采样含义；记录
    MX_HRTIM1_Init 中 FaultEnable=NONE 导致上电到首次 Pulse_*_Init 之间
    硬件封锁未生效的窗口
    - HAL_HRTIM_Fault2Callback：硬件封锁与软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
2026-09-11 docs: 修正与代码相反的错误注释, 合并 CMake 重复源文件清单
    批次 2/15。纯注释 + 构建配置改动, 零代码副作用。
    绿-5 错误注释修正 (只改注释文字, 不改代码):
    - Pulse.c 两处 PreloadEnable = HRTIM_PRELOAD_DISABLED 的注释写的是
    "开启预装载防抖", 与代码完全相反 —— 改为如实描述"预装载关闭, 写入
    立即生效, 对齐时机由 must_realign + SoftwareUpdate 显式控制"。
    这处在 N 脉冲/双脉冲模式的时基配置里, 是误导性最强的一处
    - Pulse_Frame_SetActive 上方注释写 "Y7 帧/猝发标记", 实际是 Y8。
    已核验: SYNC_OUT_Pin=PB13=Y7 (HRTIM CHC2 硬件 SYNC),
    FRAME_OUT_Pin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
    [Pulse.c]
2026-09-11 refactor: 单文件全局变量加 static 收敛符号可见性, 清理死代码
    批次 3/15。
    绿-1 static 化 (均经全工程 grep 核验无跨文件引用, volatile 一律保留):
    - main.c: display_update_flag / waiting_for_trg_flag / triggered
    (定时器 ISR 与主循环同属一个编译单元, static 不改变 volatile 语义);
    last_count / current_count / diff
    - Pulse.c: TimeBaseCfg / TimerCtl / TimerCfg / CompareCfg / OutputCfg
    (顺带消除与 hrtim.c 中同名 CubeMX 生成符号的混淆)
    - OLED_driver.c: OLED_ColorMode
    - Key.c: Key_Flag (TIM7 ISR 写 / 主循环读, 保留 volatile)
    - WouoUI_user.c: 19 个页面对象 + main_option_array / main_icon_array /
    about_* 共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
2026-09-11 refactor: 自有头文件保护宏改用非保留标识符
    批次 4/15。
    Clang-Tidy 会对 __X_H 形式的保护宏报 "reserved identifier"（C 标准保留
    双下划线开头的标识符）。本次只改 5 个本项目自有头文件：
    __PRESET_H -> PRESET_H (Preset.h)
    __KEY_H -> KEY_H (Key.h)
    __PULSE_H -> PULSE_H (Pulse.h)
    __UART_COMM_H__ -> UART_COMM_H (uart_comm.h)
    __TEST_UI_H__ -> WOUOUI_USER_H (WouoUI_user.h, 原名与文件名不符一并修正)
    范围刻意收缩（详见方案第七节"发现 2"）：
    - CubeMX 托管头文件（gpio.h / dma.h / hrtim.h / spi.h / tim.h /
    stm32g4xx_it.h / main.h / stm32g4xx_hal_con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
    [Key.h, Preset.h, Pulse.h, WouoUI_user.h]
2026-09-11 refactor: 跨文件全局状态统一由头文件声明, 消除重复/无源 extern
    批次 5/15。本批次改变跨文件契约, 已做专项验证。
    问题: UI 数据模型与少数板级变量的声明分散在各 .c 中手写, 单点改名需要同步
    修改 3 个文件, 且类型漂移无法被编译器发现:
    - g_12v_enable : 在 WouoUI_user.c 与 uart_comm.c 各手写一份
    - 7 个模式 Option[] 数组 : main.c 与 Preset.c 各手写一份 (与头文件重复)
    - comp_pair_sel_str_array : 仅 Preset.c 手写, 无任何头文件声明来源
    - setting_option_array : 仅 uart_comm.c 手写, 无任何头文件声明来源
    - OLED_DisplayBuf : uart_comm.c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
    [OLED_driver.h, Preset.c, WouoUI_user.c, WouoUI_user.h, main.c, main.h, uart_comm.c]
2026-09-11 docs: 补齐 P1/P2 换算、状态机与单位约定注释
    批次 6/15。纯注释改动, 零代码副作用。
    P1 换算与状态机:
    - Pulse_CalcPrescalerAndCounts: 八档阈值表、计数值钳位 [96, 0xFFDF] 的物理
    来源 (96 是比较事件最小宽度的绝对下限, 低于它 Reset 会被硬件漏掉)
    - Pulse_CalcNpulseTiming: 标注其 tab[8] 与上一函数是**两份独立维护的等价
    表**, 改动其一必须同步另一处
    - NPULSE_INTERVAL_COMP_US: 补 @warning —— 该值是 -O3 下实测标定, 补偿的是
    中断响应延迟, **改动优化等级或升级工具链后必须用示波器重新标定**
    (这是黄-2 取消后对该残留风险的对策)
    - Pulse_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
    [Key.c, OLED_driver.c, Preset.c, Pulse.c, Pulse.h, main.c, uart_comm.c]
2026-09-11 build: 开启 -Wall -Wextra, 隔离第三方告警, 修复 -Wextra 暴露的潜在缺陷
    批次 7/15。**本批次有真实代码改动**, 需实机抽检 H1+H2。
    一、构建配置
    - cmake/gcc-arm-none-eabi.cmake: CMAKE_C_FLAGS 增加 -Wextra。
    刻意不用 -Werror —— 本工程是 -O3 -flto, 加 -Werror 会让工具链小版本升级
    直接阻塞构建, 收益远小于代价
    - CMakeLists.txt (根, 非 CubeMX 生成文件):
    * HAL/CMSIS 头文件目录标记为 SYSTEM (走 -isystem), 不产生第三方告警;
    自有 Core/Inc 保持非 SYSTEM, 告警仍然可见
    * STM32_Drivers OBJECT 库 (ST HAL + system_stm32g4xx.c) 整体 -w
    * syscalls.c / sysmem.c 逐个 -w (newlib 桩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
    [Pulse.c, WouoUI_user.c]
2026-09-11 chore: 补充项目拼写词典, 消除拼写类告警噪音
    批次 11/15。不碰任何源码。
    CLion 的拼写检查对约 230 条领域术语误报 (全部为 INFO 级), 集中在
    RXNE/USART/HRTIM/NPULSE/COMPPWM/LPWM/EXTI/HCLK/SYSCLK 等芯片与外设缩写,
    以及 WouoUI 框架的 msgwin/spinwin/valwin 等命名。
    处理方式: 扩充 .idea/dictionaries/project.xml (原已有 9 个词, 现补至 70+),
    按四类分组: 芯片/外设寄存器缩写、本项目发波领域术语、上位机通信/编码、
    WouoUI 与 OLED 库、工具链运行时。
    **刻意不收录**的: setings / registed 一类真正的拼写错误 —— 收进词典会
    把它们永久掩盖, 与"用词典代替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
2026-09-11 chore: 新增工程级 .clang-tidy 配置
    批次 12/15。不碰任何源码。
    CLion 的 Clang-Tidy 集成在存在工程根 .clang-tidy 时**以它为准**, 不再使用
    内置默认检查集 —— 因此本文件的实际效果是**减少**告警。
    设计: 从 `-*` 全关开始, 只显式启用能发现真实缺陷的检查族
    (clang-analyzer / bugprone / cert / performance / portability), 纯风格类
    一律不开。理由: 本工程由 CubeMX 生成代码、WouoUI(MPL-2.0)、江协科技库、
    自研代码四股来源叠加, 各有风格约定, 逐条改既无实质收益又增加上游合并成本。
    显式关闭的 11 个单项均附理由, 例如:
    - bugprone-reserved-identifier: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
2026-09-11 fix: 修正 OLED.h 头文件名大小写等 5 项小问题
    批次 10/15。
    已修 (5 项):
    - OLED.h: #include "OLED_Driver.h" → "OLED_driver.h"。
    **真实可移植性缺陷**: 实际文件名是小写 d 的 OLED_driver.h, 在大小写敏感的
    文件系统 (Linux CI / Docker 构建) 上会直接编译失败, Windows 上因文件系统
    不区分大小写而被掩盖
    - Preset.c Preset_Save: memset(&d,0,sizeof(d)) → PresetData_t d = {0};
    - WouoUI_font.c: 5 个字模数组 (F6x8/F6x12/F7x12/F8X16/F12X24) 加 static,
    已核验 WouoUI_font.h 只 extern 了 Font_* 结构体
    - WouoUI_graph.c: memcmp 结果改为显式 != 0 比较。原写法 if (memcmp(...))
    **逻辑本身正确** (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
    [OLED.h, Preset.c, WouoUI_font.c, WouoUI_graph.c, uart_comm.c]
2026-09-11 refactor: 全大写变量改名消除"形似宏"的误读陷阱
    批次 8/15。
    问题: 下列 6 个标识符是**变量而非宏**, 却用全大写宏风格命名, 且全部在 ISR 中
    被异步读写 —— 阅读时极易误判为编译期常量:
    PULSE_MODE -> g_pulse_mode
    PULSE_OUT_ENABLED -> g_pulse_out_enabled
    PULSE_POLARITY -> g_pulse_polarity
    HRTIM_TIMERINDEX_TIMER_X -> g_hrtim_timer_index
    HRTIM_TIMERID_TIMER_X -> g_hrtim_timer_id
    HRTIM_OUTPUT_TXX -> g_hrtim_output
    后三者更严重: 命名形似 ST 官方宏 (HRTIM_TIMERINDEX_TIMER_A 等), 容易被当作
    库符号。改名后与既有的 g_pulse_ctrl / g_fault_fla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
    [Preset.c, Pulse.c, Pulse.h, WouoUI_user.c, main.c, uart_comm.c]
2026-09-11 refactor: SCPI 参数解析改用 strtol/strtod, 行为严格保持不变
    批次 15/15 的解析改造部分。
    8 处调用点 (均为 SCPI 参数解析路径):
    atoi -> (int)strtol(s, NULL, 10) uart_comm.c 的 PULSE:CH / PULSE:POL /
    dpulse 的 PW1 / BTN 键码, 共 4 处
    atof -> (float)strtod(s, NULL) 各模式数值参数, 共 4 处
    **行为等价性依据 (非"相近")**: 本工具链是 newlib, 其 atoi 的实现就是
    (int)strtol(str, (char **)NULL, 10), atof 即 strtod(nptr, NULL) ——
    属于同一实现, 因此替换后语义完全一致。
    刻意**不加** errno/endptr 检查: 保持"非法输入返回 0"的既有容错契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
2026-09-11 refactor: 绘图 API 坐标形参由 int16_t 加宽为 int, 消除窄化转换
    批次 14/15。**本批次有 ABI 变化与代码体积代价, 需实机 OLED 逐页回归 (H9)**。
    背景: Clang-Tidy 的 bugprone-narrowing-conversions 在本工程报出约 90 处,
    全部集中在 WouoUI_page.c 与 WouoUI_graph.c, 根因是绘图 API 用 int16_t 作
    坐标形参, 而调用处传入 int / uint16_t 表达式 —— 每次调用报一条, 逐行加 cast
    会制造 90 处噪音。
    改动: 把坐标/尺寸类形参统一加宽为 int, 涉及
    Core/Inc/WouoUI_graph.h Core/Src/WouoUI_graph.c
    Core/Inc/WouoUI_page.h Core/Src/WouoUI_page.c
    **未改动**: Canvas / SlideStr / WavePage 等结构体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
    [WouoUI_graph.c, WouoUI_graph.h, WouoUI_page.c, WouoUI_page.h]
2026-09-11 chore: 接受 CLion 对拼写词典的重排
    上一次提交后 CLion 重写了 .idea/dictionaries/project.xml: 去掉了分组注释、
    按字母序重排, 并把 77 个词条合并在一起。这是 CLion 对该文件格式的所有权,
    属预期行为 —— 后续只要在 IDE 里增删词条, 都会再次触发重排。
    已核验: 手工补入的领域词 (rxne/hrtim/npulse/comppwm/lpwm/exti/hclk/sysclk/
    pllm/scpi/prf/dmamux/picolibc 等) 全部保留, 无丢失。
    注: 该文件已被 .gitignore 的 !.idea/dictionaries/project.xml 例外纳入版本控制,
    因此 IDE 对它的改动会显示为工作区脏 —— 这是"让词典随仓库分发"的必要代价。
    若不想每次都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
2026-09-11 fix: 修复自造 USER CODE 标记, usart 迁移到 CubeMX 模板, 加重新生成防线
    批次 9 的前置工作。用户已在 CubeMX 中重新生成过一次, 暴露出一类此前未被
    察觉的系统性问题。
    一、CubeMX 重新生成实际造成的破坏 (已回退, 证据存 cubemx-regen.diff)
    1) 构建失败 21 个错误: usart.c 被移出编译列表 / HAL_UART_MODULE_ENABLED
    被注释 / main.c 的 MX_USART3_UART_Init() 调用被删
    2) **TICK_INT_PRIORITY 被从 (0UL) 静默改回 (15UL)** —— 那个 0 是提交
    d9f4480 "resolve interrupt priority inversion, isr deadlocks, and
    concurrent state race conditions" 刻意改的。.ioc 里至今仍是 15, 当年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
    [main.h, usart.c, usart.h]
2026-09-11 fix(usart): 合并自研 ISR 到 CubeMX 生成的中断函数, 完成 USART3 归 .ioc 管理
    批次 9 收尾。用户第二次 CubeMX 重新生成成功 —— 防线脚本 12 项全部通过,
    `.ioc` 现在与代码一致 (NVIC.SysTick_IRQn 已是 0)。
    一、这次重新生成是**成功的**, 与上次失败形成对照
    上次 (失败): 构建 21 个错误 + TICK_INT_PRIORITY 被静默改回 15
    这次: 检查脚本 12 项全绿, 关键项复核:
    TICK_INT_PRIORITY = (0UL) ✓ .ioc SysTick 优先级 = 0 ✓
    HAL_UART 已启用 ✓ MX_USART3_UART_Init 被调用 ✓
    顺带清掉了我上次遗留的冗余: 提交 4580233 里 g_12v_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
    [G474PulseGen.ioc, main.c, main.h, usart.c, usart.h]
2026-09-11 chore: 防线增加 Overrun Disable 检查
    把 USART3 的 OVRDIS 纳入重新生成防线 —— 它与 TICK_INT_PRIORITY 属同一类
    问题: 编译通过、运行正常, 却把一处刻意的设计静默废掉。
    新增 require_not_match / advise_not_match 两个反查宏 (原只有正向匹配):
    FATAL Core/Src/usart.c 不得出现 UART_ADVFEATURE_OVERRUN_DISABLE
    ADVISORY .ioc 不得残留 USART3.OverrunDisableParam / DMADisableonRxErrorParam
    .ioc 侧刻意用 ADVISORY 而非 FATAL: 若代码已干净、只是 .ioc 还勾着, 当前构建
    其实没问题 (要下次重新生成才出问题), 此时只提示即可。
2026-09-11 chore: 完成 USART3 归 .ioc 管理 —— 关闭 Overrun Disable, 修正检查误报
    批次 9 完成。
    一、CubeMX 第三次重新生成的结果是**干净的**
    改动文件从上次的 10 个降到 3 个 (usart.c / .ioc / 本检查脚本), 说明
    CubeMX 现在对这个工程已是幂等的。关键项全部正确:
    TICK_INT_PRIORITY = (0UL) ✓ .ioc NVIC.SysTick_IRQn = 0 ✓
    usart.c 的 AdvancedInit = UART_ADVFEATURE_NO_INIT ✓ (Overrun Disable 已关)
    这样固件里基于 ORE 的风暴保护完整生效:
    uart_comm.c:628 使能 UART_IT_ORE / :654 UartComm_OreEvent 计数 /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
    [G474PulseGen.ioc, usart.c]
2026-09-11 fix(pulse): N 脉冲间隔补偿常量按五点实测重新标定 0.9 → 0.97
    实机验证中新发现的既有标定偏差, 与本次 18 个提交无关
    (基线固件与新固件表现一致, 已实机确认)。
    问题: 设定间隔普遍偏长约 70ns。用户实测 —— 设定 1/2/4/8/16µs, 实测
    1.06~1.12 / 2.06~2.10 / 4.06~4.10 / 8.06~8.07 / 16.07~16.09。
    分析方法 (补偿作用在分频档选择之前, 是纯 µs 时间偏移):
    硬件周期 = pw + (设定间隔 − COMP)
    实际间隔 = 硬件周期 + 真实开销
    => 真实开销 = 实测 − 设定 + COMP
    反推五点开销: 0.96~1.02 / 0.96~1.00 / 0.96~1.00 / 0.96~0.97 / 0.97~0.99
    **五点下界全部落在 0.96,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
    [Pulse.c]
2026-09-11 docs(pulse): 记录 N 脉冲间隔补偿常量的改后复测结果, 标定闭环
    接 abeca1e。补偿常量改为 0.97 后的同条件复测:
    设定 1µs → 1.005~1.045 (中心 1.025 = 钳位 0.05 + 开销 0.975, 与模型吻合)
    设定 2µs → 1.98~2.00 (残差 -10ns)
    设定 4µs → 3.98~4.02 (残差 0)
    设定 8µs → 7.99~8.01 (残差 0)
    设定 16µs → 15.98~16.01 (残差 -5ns)
    2/4/8/16µs 的中心残差均 ≤10ns, 远小于 20~40ns 的抖动展宽 —— 已无可检测的
    系统性偏差, 剩余误差全部来自中断响应抖动 (非补偿常量所能改善)。
    结论写入注释并注明"标定到此为止, 不要再调这个值", 避免后人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
2026-09-11 docs: 归档代码卫生改动的实机验收数据
    原位于 pc_host/dist/screenshots/ —— 该目录被 .gitignore 忽略, 清理构建产物
    时会一并丢失。移入被跟踪的 screenshots/ 下长期保存。
    结构 (按固件版本 + 验证清单项编号组织, 编号保留以便与清单对应):
    verification_2026-09/baseline_4fdba09/ 0-1_sync_jitter.png
    0-4_oled_pages/ (13 张)
    0-5_scpi_responses.txt
    verification_2026-09/after_code-hygiene/ 1-1_sync_jitter.png
    1-3_oled_pages/ (13 张)
    2-1_scpi_resp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
2026-09-11 docs: 同步补偿常量标定结果, 清理空壳 API 与告警抑制名单
    四件事, 外加一处对我自己先前结论的更正:
    1. 补偿常量文档同步 (0.9 -> 0.97)
    README 的 4.4 节与"踩过的坑"、验证清单页面仍在写 0.9f, 而 Pulse.c 已在
    abeca1e/fbef12f 重新标定为 0.97f。其中"改成 0.9f 后示波器读数才对上"是
    错误论断 —— 0.9 恰是系统性偏小约 70ns 的那个值。已按 Pulse.c 的标定注释
    重写, 补上五点实测方法与短间隔钳位边界。
    验证清单 536 行的预测值也与已归档实测对不上, 改为实测值。
    2. 删除空壳 API OLED_UpdateArea()
    函数体只有一句 OLED_Update(), 四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
2026-09-11 chore: 项目级检查配置入库, 让 CLion 检查项在克隆后即生效
    .idea/inspectionProfiles/ 下两个文件纳入版本控制:
    G474PulseGen.xml profile 内容 (哪些检查被降级/关闭)
    profiles_settings.xml 记录当前激活的 profile 名
    后者必须一并提交 —— 只提交前者的话, 重新克隆后 profile 文件存在, 但没有任何
    profile 被选中, 配置静默失效。这种"文件在、没生效"的状态比不提交更难排查。
    .gitignore 沿用 .idea/* + 白名单的写法 (与 dictionaries 同一做法, 因为 git
    无法重新包含父目录已被排除的文件)。workspace.xml / editor.xml / misc.xml /
    codeStyles 等本机状态仍保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
2026-09-11 docs: 去掉开篇"一句话："前缀
    正文本身已是完整句子, 前缀属于冗余的引导词, 删掉后开篇更直接。
2026-09-11 docs: 记录样板阶段的硬件偏差与三处失效引用
    新增 HARDWARE.md §1.1「样板状态与已知硬件问题」, 置于 §1 概况之后、引脚表之前 ——
    本文档是硬件单一事实源, 读者需带着"这是样板、有已知偏差"的前提去读引脚表与
    电源拓扑, 否则会把标称设计当成实物现状。
    八项偏差 (源文件未入库 / OLED 无支撑柱 / U3 替代件 / 输出阻抗匹配 / 背板孔位 /
    蓝牙口改接 / 尺寸 / BOM 成本) 汇总为一张表, 表尾标明: 引脚分配、电气有效电平与
    极性约定不受影响, 其余章节仍然有效。
    U3 替代件确认为 TLV76150 (5.0V 档), 与 NCV7805 同输出电平, 故 §1 的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
2026-09-11 chore: 裁剪仓库体积, 移出未参与构建的 CMSIS DSP/NN 与压缩漏压截图
    仓库此前 88.55 MiB / 1291 个跟踪文件, 其中超过一半是编译无关的死重。
    本提交处理后降到约 30 MiB。
    1) 移出 Drivers/CMSIS/DSP (43.5 MiB, 715 文件) 与 Drivers/CMSIS/NN (1.3 MiB)
    CubeMX 生成工程时会把整个 CMSIS pack 拷进来, 这两个子库本工程从未使用:
    全仓对 arm_math.h / arm_nn 零引用, 根 CMakeLists.txt 只把 HAL_Inc /
    HAL_Inc_Legacy / CMSIS_Device_Inc / CMSIS_Include 四个目录加进构建。
    其中仅 DSP/Lib 下的 6 个 .a + 4 个 .lib 预编译库就有约 32 MB。
    验证: 移开目录后 rm -rf build/Debug 全新配置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
2026-09-11 docs: 补齐第三方许可正文与上位机依赖署名
    开源合规审计发现四处形式性缺口, 本提交逐条补齐。
    1) 新增 LICENSE-MPL-2.0 (正文 373 行)
    16 个 WouoUI 框架文件此前只有文件头里的 URL 指向 MPL, 根目录又是 MIT,
    接收者容易整体误读为「全仓 MIT」。现提供正文副本。
    文本取自 mozilla.org 官方发布版, 未作改动。
    2) 新增 LICENSE-BSD-3-Clause (正文)
    ST HAL 与 startup_stm32g474xx.s 适用此许可, 此前只有一句 opensource.org
    的 URL —— 而 BSD-3-Clause 第 2 条明确要求再分发时复制「版权声明、条款列表
    与免责声明」三者, 仅给链接技术上未满足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
2026-09-11 docs: 补齐「从零到跑通」的构建前置条件, 并明确可共建范围
    社区共建定位下, 最大的门槛是别人克隆下来跑不起来。审计发现 README §9
    只给了两条 cmake 命令, 从「装工具链」到「敲第一条命令」之间全靠读者自己知道。
    1) README §9 重写为「从零到跑通」, 由 3 小节扩为 5 小节
    - 新增 §9.1 工具链准备: 三样工具的版本要求与实测版本
    (GNU Tools for STM32 14.3.rel1 / CMake 4.3.1 / Ninja 1.13.2),
    推荐走 STM32CubeCLT 一次装齐, 附 PATH 排查提示。
    并明确 **不需要装 CubeMX** —— Drivers/ 已随仓库入库。
    - §9.2 编译: 补充 Release preset、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
2026-09-11 ci: 新增 GitHub Actions 构建验证与 issue 表单
    「社区共建」最实际的抓手是让贡献者的 PR 能被自动验证 —— 在此之前,
    唯一的门槛只写在 CONTRIBUTING.md 里, 全靠人工自觉。
    .github/workflows/build.yml
    push / PR / 手动触发, Debug 与 Release 双 preset 矩阵。
    流程: 装工具链 -> 配置 -> 编译 -> 检查零告警 -> 确认产物 -> 上传 elf 与 size。
    关键一步是「检查编译告警」: 本工程 -Wall -Wextra 全开但不加 -Werror,
    告警不会挡住构建, 所以由 CI 兜底并置为失败。
    ⚠ 这一步的实现踩了一次坑, 记录下来:
    最初的写法是 `grep -E 'warning:'`, 以为能靠前缀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
2026-09-11 chore: 历史清理后同步基线 commit hash 引用 (4fdba09 -> fbbc384)
    上一提交用 git filter-repo 重写了全部历史, 所有 commit hash 因此变化。
    本次同步更新指向基线的引用。
    背景
    ----
    为开源发布做准备, 清理两处历史遗留:
    1. Core/Src/OLED_Fonts.c 的字库注释里含 21 处 Windows 本机绝对路径 ——
    取模工具自动生成时把源位图的完整路径写进了注释, 其中含当前用户名下的
    OneDrive 目录。该字符串贯穿全部历史提交, 只改工作树无效, 必须改写历史。
    替换目标是完整路径前缀而非裸数字: 后者的数值在 CMSIS 数据表里恰好也有,
    会误伤那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
2026-09-11 refactor: 消除三处移植障碍 (时钟/端口/Flash地址)
    为开源后的"社区共建"定位做准备。审计发现三处会让移植者踩坑的地方,
    其中两处属于"改错了编译器不报错"的类型。
    1) 时钟基准 170MHz 由 21 处裸字面量收归单一宏
    新增 Pulse.h 的 PULSE_HRTIM_CLK_HZ (整型) 与 PULSE_HRTIM_CLK_HZ_F
    (浮点, 由前者派生), 替换 Pulse.c 中全部 21 处。
    原先没有任何封装, 也没用 HAL_RCC_GetHCLKFreq —— 换主频时必须全局替换,
    而**改漏一处不会编译报错**, 只会让某个分频档的时间悄悄算错。
    现在改一处即可, 注释里写明与 SystemClock_Config() 的绑定关系。
    2)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
2026-09-11 docs: 新增 PORTING.md 移植指南, 并接入 README
    回答"这份代码方不方便让别人移植"。结论分两层, 文档也照这个结构写。
    第一节先说**前提**: STM32G4 里只有 G474/G484 带 HRTIM1, 其余型号
    (G431/G441/G471/G473/G483/G491/G4A1) 根本没有这个外设, 移植无从谈起。
    这条不先说清, 读者可能花很多时间才发现方向不对。
    依据: 本仓库 CMSIS 器件头中只有 g474/g484/g414 定义了 HRTIM1_BASE。
    第二节分"借思路"与"整包搬"两种情况:
    - 借思路容易 —— 列了可以直接抄的算法与设计 (分频选档、多脉冲补偿的标定
    方法、三层保护的顺序理由、check_regen_invariants.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
2026-09-11 feat: 新增 HRTIM 时钟基准的构建期不变量检查
    上一提交把 170MHz 收归宏后, 宏本身与时钟树的一致性仍靠人工维护 ——
    而"漏改"正是这个宏当初要解决的隐患。补上自动防线。
    新增检查 (FATAL 级, 不通过则中断构建):
    .ioc 的 RCC.APB2TimFreq_Value == Pulse.h 的 PULSE_HRTIM_CLK_HZ
    为什么比对的是 APB2 定时器时钟而不是 SYSCLK:
    G4 的 HRTIM 时钟源**不可选** —— HAL 里没有 RCC_HRTIM1CLK_* 之类的选项,
    CK_HRTIM 跟着 APB2 定时器时钟走。本工程 APB2 分频为 DIV2, 于是该值
    = 2 x PCLK2 = 170MHz, 恰好等于 SYSCLK; 但这是当前分频配置的结果,
    不是普遍规律 —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
2026-09-11 feat: 新增重构静态验证脚本, 并在 CONTRIBUTING 中接入
    「社区共建」定位下, 贡献者改完时序代码该怎么证明"没改坏"是个空白 ——
    CONTRIBUTING 原先只要求"附示波器波形", 但实机验证成本高, 且挡不住
    "把 GPIOA 写成 GPIOB"这类编译能过的低级错误。
    scripts/verify_refactor.sh
    save (改动前: 采集基线) / check (改动后: 比对)
    判据三级: 逐字节一致 = 纯重构; 仅体积变化且符号一致 = 实现变更;
    符号集合有增删 = 接口变更需人工审查。
    内置 LTO 符号归一化 (.lto_priv.N 与 <file>.c.<hash>), 否则 diff 全是噪音。
    CONTRIBUTING 新增「改动后怎么验证」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
2026-09-11 chore: 发布前终审 —— 清理内部术语与失效引用, 移出 AI 工具本机配置
    公开前的最后一次扫描, 修掉三类对外部读者不成立的内容。
    1) cmake/check_regen_invariants.cmake 的失败提示指向不存在的文档
    原文「或参考方案文档的批次 9」—— 那份方案文档从未入库。FATAL 报错时
    读者被指向虚空, 而 FATAL 恰恰是最需要给出路的时候。
    改为自洽的三步处置指引, 并指向 README §9.5; 另补一句「若报提取失败,
    说明本脚本正则已过期, 请更新它」。
    2) 两份实机验收记录里的内部术语与失效命令
    .claude/checklist.html 与 screenshots/verification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
2026-09-11 fix(ci): 补装 newlib 标准库头, 并升级 Action 版本消除 Node 20 告警
    CI 首次运行失败, 原因是我的安装命令写错了。
    根因
    报错:
    Core/Inc/OLED_driver.h:12:10: fatal error: string.h: No such file or directory
    Ubuntu 上 C 标准库头 (string.h / stdint.h 等) 由**单独的包**
    libnewlib-arm-none-eabi 提供, 而它是 gcc-arm-none-eabi 的 **Recommends**
    而非 Depends。我原先写了 `apt-get install --no-install-recommends`,
    正好把它跳过 —— 于是只有编译器、没有标准库头。
    这个错误很有迷惑性: HAL 那些不用标准库头的文件全部编译通过, 一直到
    [2/50] OLED.c 才炸, 看上去像某个文件的问题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
2026-09-11 fix: 修正 main.c 的 include 大小写, 并新增构建期检查防止再犯
    顺着 CI 首次失败往下查, 发现下一个必然的失败点 —— 它与 newlib 那次是两回事。
    真正的 bug
    ----------
    Core/Src/main.c 写的是 #include "oled.h", 而实际文件名是 OLED.h。
    Windows 的文件系统不区分大小写, 所以在开发机上永远编得过; Linux (含 CI)
    直接 "No such file or directory"。这与 2026-09 修过的那次是同一类错误
    (OLED_Driver.h -> OLED_driver.h), 只是换了个文件 —— 说明靠人眼防不住。
    该行位于 /* USER CODE BEGIN Includes */ 保护区内, 可直接改, 不会被
    CubeMX 重新生成覆盖。
    新增检查
    --------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
    [main.c]
2026-09-11 fix(ci): upload-artifact 升到 v6 —— v5 仍跑在 Node 20
    上一提交把 upload-artifact 从 v4 升到 v5, 以为 v5 就是 Node 24。**猜错了。**
    v5 只是"初步支持" Node 24, runs.using 仍是 node20, 所以告警照旧:
    Node.js 20 is deprecated. ... actions/upload-artifact@v5
    v6 才把运行时切到 node24 (v5.0.0 的发布说明把该改动标为 BREAKING, 实际只是
    运行时切换, 输入参数不变; 需要 Actions Runner >= 2.327.1, 只影响自建 runner)。
    对比之下 checkout 不一样 —— checkout@v5 已经是 Node 24, 所以只有
    upload-artifact 报了警告。两个 action 的"第一个 Node 24 版本"并不同步, 这点
    已写进 workflow 的行内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
2026-10-19 feat(pc_host): 增加 DPT SCPI 参数扫描脚本
